yhetti/violet/README.md

# Violet
a GreatFET neighbor that is a jig for testing Gladiolus

Required KiCad dependency:

https://github.com/greatscottgadgets/gsg-kicad-lib

If you are using git, the preferred way to install gsg-kicad-lib is to use the
submodule:

```
git submodule init && git submodule update
```
