yhetti/violet/violet.kicad_pcb

## KiCad design violet.kicad_pcb (2021-01-21)

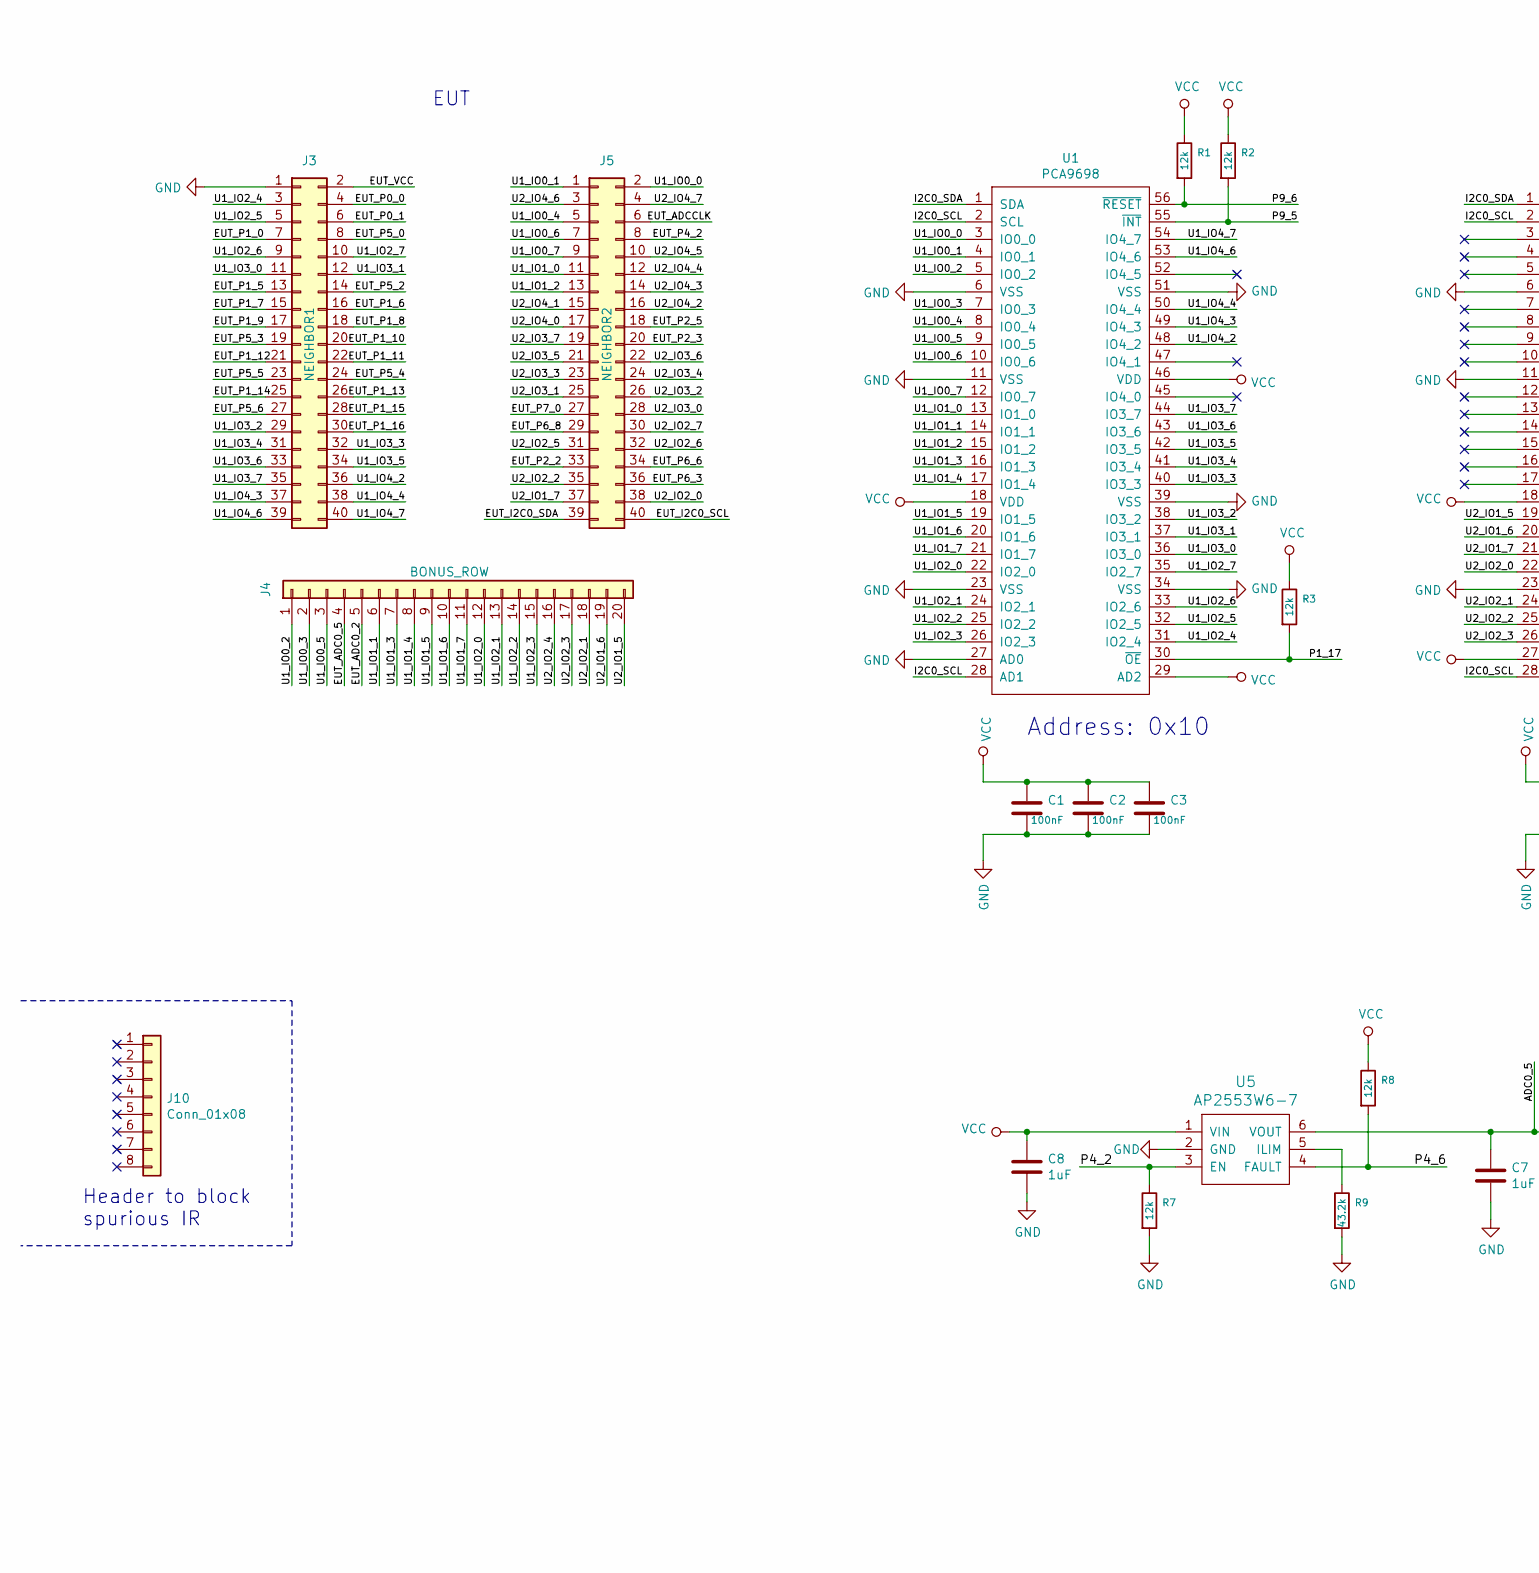
[picture p1: schematic violet.sch, part in row 1, column 1]

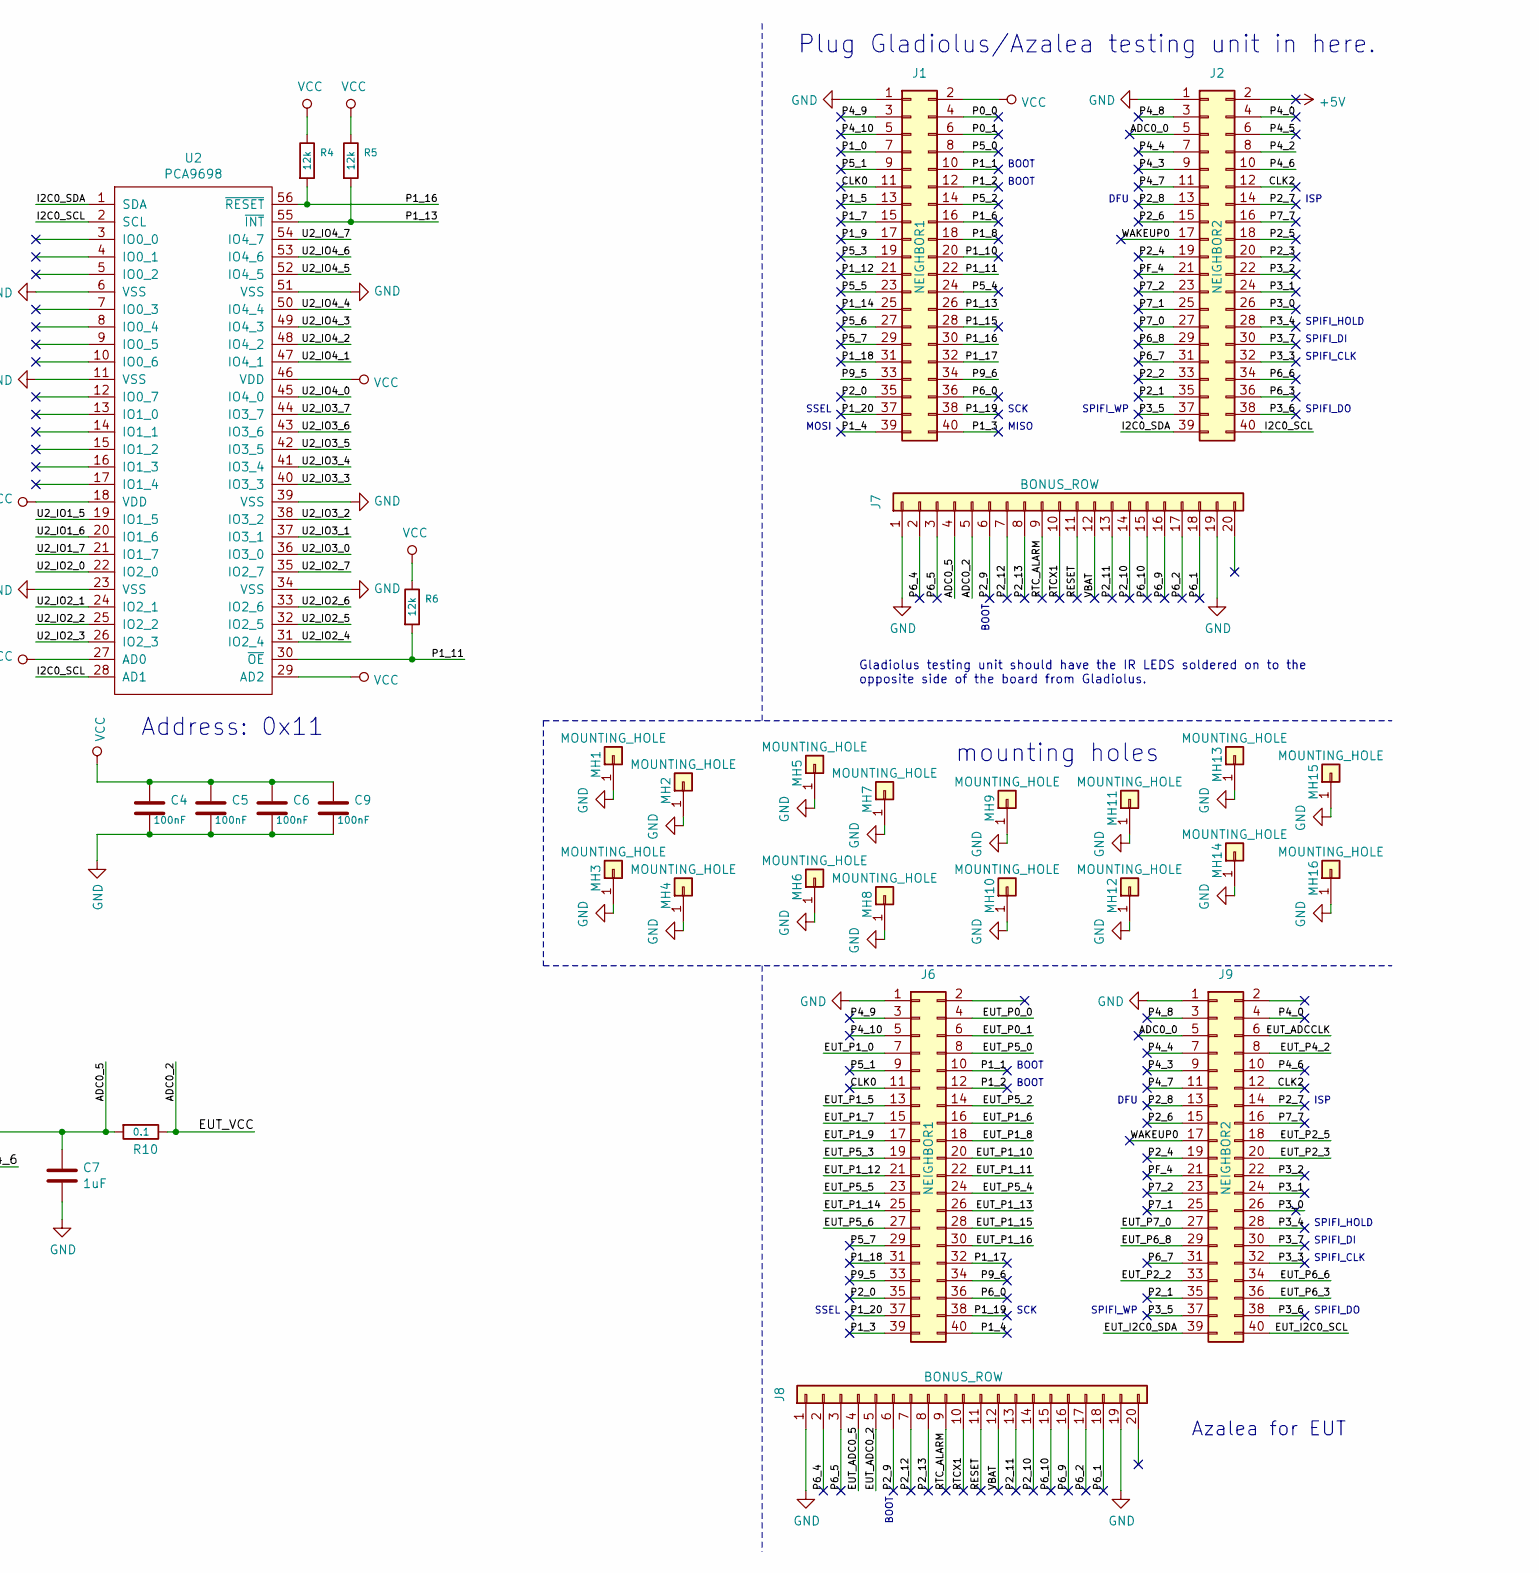
[picture p2: schematic violet.sch, part in row 1, column 2]

Parts:
C1, C2, C3, C4, C5, C6, C9: 100nF; 0603; Part Number C0603C104M4RACTU
C7, C8: 1uF; 0603; Part Number CL10A105KP8NNNC
J1, J3, J6: NEIGHBOR1; HEADER-2x20; Part Number PH2-20-UA
J2, J5, J9: NEIGHBOR2; HEADER-2x20; Part Number PH2-20-UA
J4, J7, J8: BONUS_ROW; HEADER-1x20; Part Number SSQ-120-23-G-S
J10: Conn_01x08; HEADER-1x8; Part Number SSQ-108-01-G-S
MH1, MH2, MH3, MH4, MH5, MH6, MH7, MH8, MH9, MH10, MH11, MH12, MH13, MH14, MH15, MH16: MOUNTING_HOLE; HOLE126MIL-COPPER
R1, R2, R3, R4, R5, R6, R7, R8: 12k; 0603; Part Number RMCF0603FT12K0
R9: 43.2k; 0603; Part Number RC0603FR-0743K2L
R10: 0.1; 0603; Part Number ERJ-3RSFR10V
U1, U2: PCA9698; TSSOP56; Part Number PCA9698DGG,512
U5: AP2553W6-7; SOT457

Connections:
+5V: J2.2
/ADC0_0: J2.5, J9.5
/ADC0_2: J3.2, J7.5, R10.1
/ADC0_5: C7.1, J7.4, R10.2, U5.6 (VOUT)
/CLK0: J1.11, J6.11
/CLK2: J2.12, J9.12
/EUT_ADC0_2: J4.5, J8.5
/EUT_ADC0_5: J4.4, J8.4
/EUT_ADCCLK: J5.6, J9.6
/EUT_I2C0_SCL: J5.40, J9.40
/EUT_I2C0_SDA: J5.39, J9.39
/EUT_P0_0: J3.4, J6.4
/EUT_P0_1: J3.6, J6.6
/EUT_P1_0: J3.7, J6.7
/EUT_P1_5: J3.13, J6.13
/EUT_P1_6: J3.16, J6.16
/EUT_P1_7: J3.15, J6.15
/EUT_P1_8: J3.18, J6.18
/EUT_P1_9: J3.17, J6.17
/EUT_P1_10: J3.20, J6.20
/EUT_P1_11: J3.22, J6.22
/EUT_P1_12: J3.21, J6.21
/EUT_P1_13: J3.26, J6.26
/EUT_P1_14: J3.25, J6.25
/EUT_P1_15: J3.28, J6.28
/EUT_P1_16: J3.30, J6.30
/EUT_P2_2: J5.33, J9.33
/EUT_P2_3: J5.20, J9.20
/EUT_P2_5: J5.18, J9.18
/EUT_P4_2: J5.8, J9.8
/EUT_P5_0: J3.8, J6.8
/EUT_P5_2: J3.14, J6.14
/EUT_P5_3: J3.19, J6.19
/EUT_P5_4: J3.24, J6.24
/EUT_P5_5: J3.23, J6.23
/EUT_P5_6: J3.27, J6.27
/EUT_P6_3: J5.36, J9.36
/EUT_P6_6: J5.34, J9.34
/EUT_P6_8: J5.29, J9.29
/EUT_P7_0: J5.27, J9.27
/I2C0_SCL: J2.40, U1.2 (SCL), U1.28 (AD1), U2.2 (SCL), U2.28 (AD1)
/I2C0_SDA: J2.39, U1.1 (SDA), U2.1 (SDA)
/P0_0: J1.4
/P0_1: J1.6
/P1_0: J1.7
/P1_1: J1.10, J6.10
/P1_2: J1.12, J6.12
/P1_3: J1.40, J6.39
/P1_4: J1.39, J6.40
/P1_5: J1.13
/P1_6: J1.16
/P1_7: J1.15
/P1_8: J1.18
/P1_9: J1.17
/P1_10: J1.20
/P1_11: J1.22, R6.2, U2.30 (~OE~)
/P1_12: J1.21
/P1_13: J1.26, R5.2, U2.55 (~INT~)
/P1_14: J1.25
/P1_15: J1.28
/P1_16: J1.30, R4.2, U2.56 (~RESET~)
/P1_17: J1.32, J6.32, R3.2, U1.30 (~OE~)
/P1_18: J1.31, J6.31
/P1_19: J1.38, J6.38
/P1_20: J1.37, J6.37
/P2_0: J1.35, J6.35
/P2_1: J2.35, J9.35
/P2_2: J2.33
/P2_3: J2.20
/P2_4: J2.19, J9.19
/P2_5: J2.18
/P2_6: J2.15, J9.15
/P2_7: J2.14, J9.14
/P2_8: J2.13, J9.13
/P2_9: J7.6, J8.6
/P2_10: J7.14, J8.14
/P2_11: J7.13, J8.13
/P2_12: J7.7, J8.7
/P2_13: J7.8, J8.8
/P3_0: J2.26, J9.26
/P3_1: J2.24, J9.24
/P3_2: J2.22, J9.22
/P3_3: J2.32, J9.32
/P3_4: J2.28, J9.28
/P3_5: J2.37, J9.37
/P3_6: J2.38, J9.38
/P3_7: J2.30, J9.30
/P4_0: J2.4, J9.4
/P4_2: J2.8, R7.1, U5.3 (EN)
/P4_3: J2.9, J9.9
/P4_4: J2.7, J9.7
/P4_5: J2.6
/P4_6: J2.10, J9.10, R8.2, U5.4 (FAULT)
/P4_7: J2.11, J9.11
/P4_8: J2.3, J9.3
/P4_9: J1.3, J6.3
/P4_10: J1.5, J6.5
/P5_0: J1.8
/P5_1: J1.9, J6.9
/P5_2: J1.14
/P5_3: J1.19
/P5_4: J1.24
/P5_5: J1.23
/P5_6: J1.27
/P5_7: J1.29, J6.29
/P6_0: J1.36, J6.36
/P6_1: J7.18, J8.18
/P6_2: J7.17, J8.17
/P6_3: J2.36
/P6_4: J7.2, J8.2
/P6_5: J7.3, J8.3
/P6_6: J2.34
/P6_7: J2.31, J9.31
/P6_8: J2.29
/P6_9: J7.16, J8.16
/P6_10: J7.15, J8.15
/P7_0: J2.27
/P7_1: J2.25, J9.25
/P7_2: J2.23, J9.23
/P7_7: J2.16, J9.16
/P9_5: J1.33, J6.33, R2.2, U1.55 (~INT~)
/P9_6: J1.34, J6.34, R1.2, U1.56 (~RESET~)
/PF_4: J2.21, J9.21
/RESET: J7.11, J8.11
/RTCX1: J7.10, J8.10
/RTC_ALARM: J7.9, J8.9
/U1_IO0_0: J5.2, U1.3 (IO0_0)
/U1_IO0_1: J5.1, U1.4 (IO0_1)
/U1_IO0_2: J4.1, U1.5 (IO0_2)
/U1_IO0_3: J4.2, U1.7 (IO0_3)
/U1_IO0_4: J5.5, U1.8 (IO0_4)
/U1_IO0_5: J4.3, U1.9 (IO0_5)
/U1_IO0_6: J5.7, U1.10 (IO0_6)
/U1_IO0_7: J5.9, U1.12 (IO0_7)
/U1_IO1_0: J5.11, U1.13 (IO1_0)
/U1_IO1_1: J4.6, U1.14 (IO1_1)
/U1_IO1_2: J5.13, U1.15 (IO1_2)
/U1_IO1_3: J4.7, U1.16 (IO1_3)
/U1_IO1_4: J4.8, U1.17 (IO1_4)
/U1_IO1_5: J4.9, U1.19 (IO1_5)
/U1_IO1_6: J4.10, U1.20 (IO1_6)
/U1_IO1_7: J4.11, U1.21 (IO1_7)
/U1_IO2_0: J4.12, U1.22 (IO2_0)
/U1_IO2_1: J4.13, U1.24 (IO2_1)
/U1_IO2_2: J4.14, U1.25 (IO2_2)
/U1_IO2_3: J4.15, U1.26 (IO2_3)
/U1_IO2_4: J3.3, U1.31 (IO2_4)
/U1_IO2_5: J3.5, U1.32 (IO2_5)
/U1_IO2_6: J3.9, U1.33 (IO2_6)
/U1_IO2_7: J3.10, U1.35 (IO2_7)
/U1_IO3_0: J3.11, U1.36 (IO3_0)
/U1_IO3_1: J3.12, U1.37 (IO3_1)
/U1_IO3_2: J3.29, U1.38 (IO3_2)
/U1_IO3_3: J3.32, U1.40 (IO3_3)
/U1_IO3_4: J3.31, U1.41 (IO3_4)
/U1_IO3_5: J3.34, U1.42 (IO3_5)
/U1_IO3_6: J3.33, U1.43 (IO3_6)
/U1_IO3_7: J3.35, U1.44 (IO3_7)
/U1_IO4_2: J3.36, U1.48 (IO4_2)
/U1_IO4_3: J3.37, U1.49 (IO4_3)
/U1_IO4_4: J3.38, U1.50 (IO4_4)
/U1_IO4_6: J3.39, U1.53 (IO4_6)
/U1_IO4_7: J3.40, U1.54 (IO4_7)
/U2_IO1_5: J4.20, U2.19 (IO1_5)
/U2_IO1_6: J4.19, U2.20 (IO1_6)
/U2_IO1_7: J5.37, U2.21 (IO1_7)
/U2_IO2_0: J5.38, U2.22 (IO2_0)
/U2_IO2_1: J4.18, U2.24 (IO2_1)
/U2_IO2_2: J5.35, U2.25 (IO2_2)
/U2_IO2_3: J4.17, U2.26 (IO2_3)
/U2_IO2_4: J4.16, U2.31 (IO2_4)
/U2_IO2_5: J5.31, U2.32 (IO2_5)
/U2_IO2_6: J5.32, U2.33 (IO2_6)
/U2_IO2_7: J5.30, U2.35 (IO2_7)
/U2_IO3_0: J5.28, U2.36 (IO3_0)
/U2_IO3_1: J5.25, U2.37 (IO3_1)
/U2_IO3_2: J5.26, U2.38 (IO3_2)
/U2_IO3_3: J5.23, U2.40 (IO3_3)
/U2_IO3_4: J5.24, U2.41 (IO3_4)
/U2_IO3_5: J5.21, U2.42 (IO3_5)
/U2_IO3_6: J5.22, U2.43 (IO3_6)
/U2_IO3_7: J5.19, U2.44 (IO3_7)
/U2_IO4_0: J5.17, U2.45 (IO4_0)
/U2_IO4_1: J5.15, U2.47 (IO4_1)
/U2_IO4_2: J5.16, U2.48 (IO4_2)
/U2_IO4_3: J5.14, U2.49 (IO4_3)
/U2_IO4_4: J5.12, U2.50 (IO4_4)
/U2_IO4_5: J5.10, U2.52 (IO4_5)
/U2_IO4_6: J5.3, U2.53 (IO4_6)
/U2_IO4_7: J5.4, U2.54 (IO4_7)
/VBAT: J7.12, J8.12
/WAKEUP0: J2.17, J9.17
GND: C1.2, C2.2, C3.2, C4.2, C5.2, C6.2, C7.2, C8.2, C9.2, J1.1, J2.1, J3.1, J6.1, J7.1, J7.19, J8.1, J8.19, J9.1, MH1.1, MH2.1, MH3.1, MH4.1, MH5.1, MH6.1, MH7.1, MH8.1, MH9.1, MH10.1, MH11.1, MH12.1, MH13.1, MH14.1, MH15.1, MH16.1, R7.2, R9.2, U1.6 (VSS), U1.11 (VSS), U1.23 (VSS), U1.27 (AD0), U1.34 (VSS), U1.39 (VSS), U1.51 (VSS), U2.6 (VSS), U2.11 (VSS), U2.23 (VSS), U2.34 (VSS), U2.39 (VSS), U2.51 (VSS), U5.2 (GND)
unnamed: R9.1, U5.5 (ILIM)
VCC: C1.1, C2.1, C3.1, C4.1, C5.1, C6.1, C8.1, C9.1, J1.2, R1.1, R2.1, R3.1, R4.1, R5.1, R6.1, R8.1, U1.18 (VDD), U1.29 (AD2), U1.46 (VDD), U2.18 (VDD), U2.27 (AD0), U2.29 (AD2), U2.46 (VDD), U5.1 (VIN)

Notes on the sheet:
MISO
MOSI
SCK
SSEL
ISP
DFU
BOOT
SPIFI_CLK
SPIFI_HOLD
SPIFI_WP
SPIFI_DO
SPIFI_DI
Gladiolus testing unit should have the IR LEDS soldered on to the opposite side of the board from Gladiolus.
Plug Gladiolus/Azalea testing unit in here.
mounting holes
EUT
Azalea for EUT
Address: 0x10
Address: 0x11
Header to block spurious IR

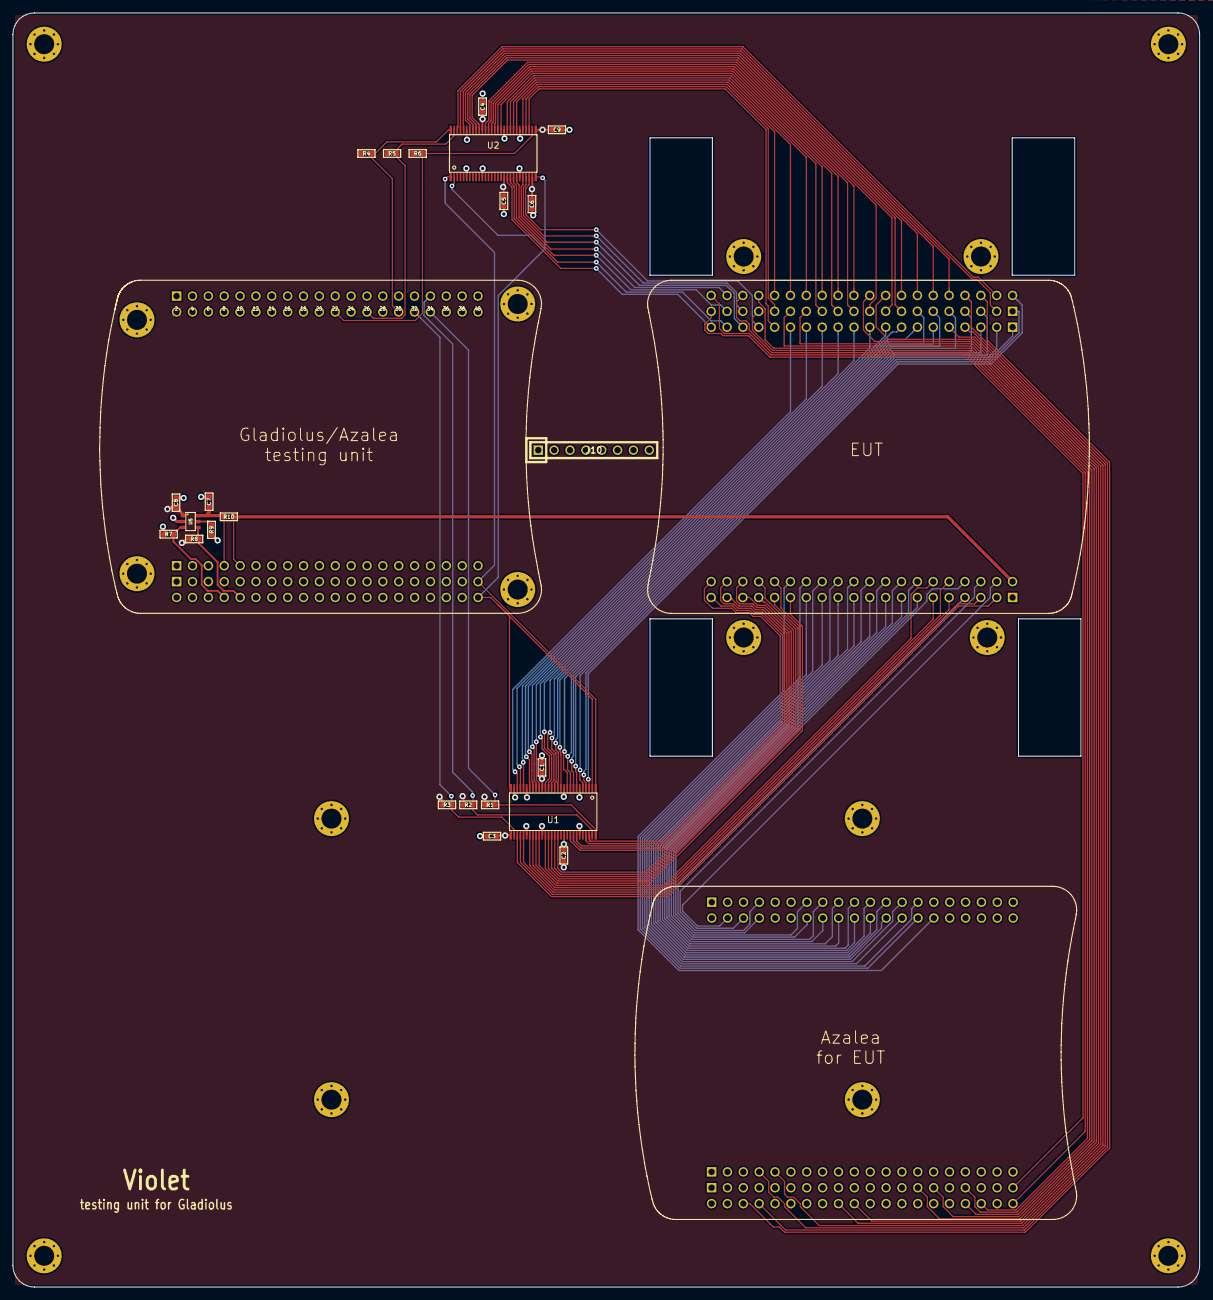
[picture p3: board violet.kicad_pcb from above]

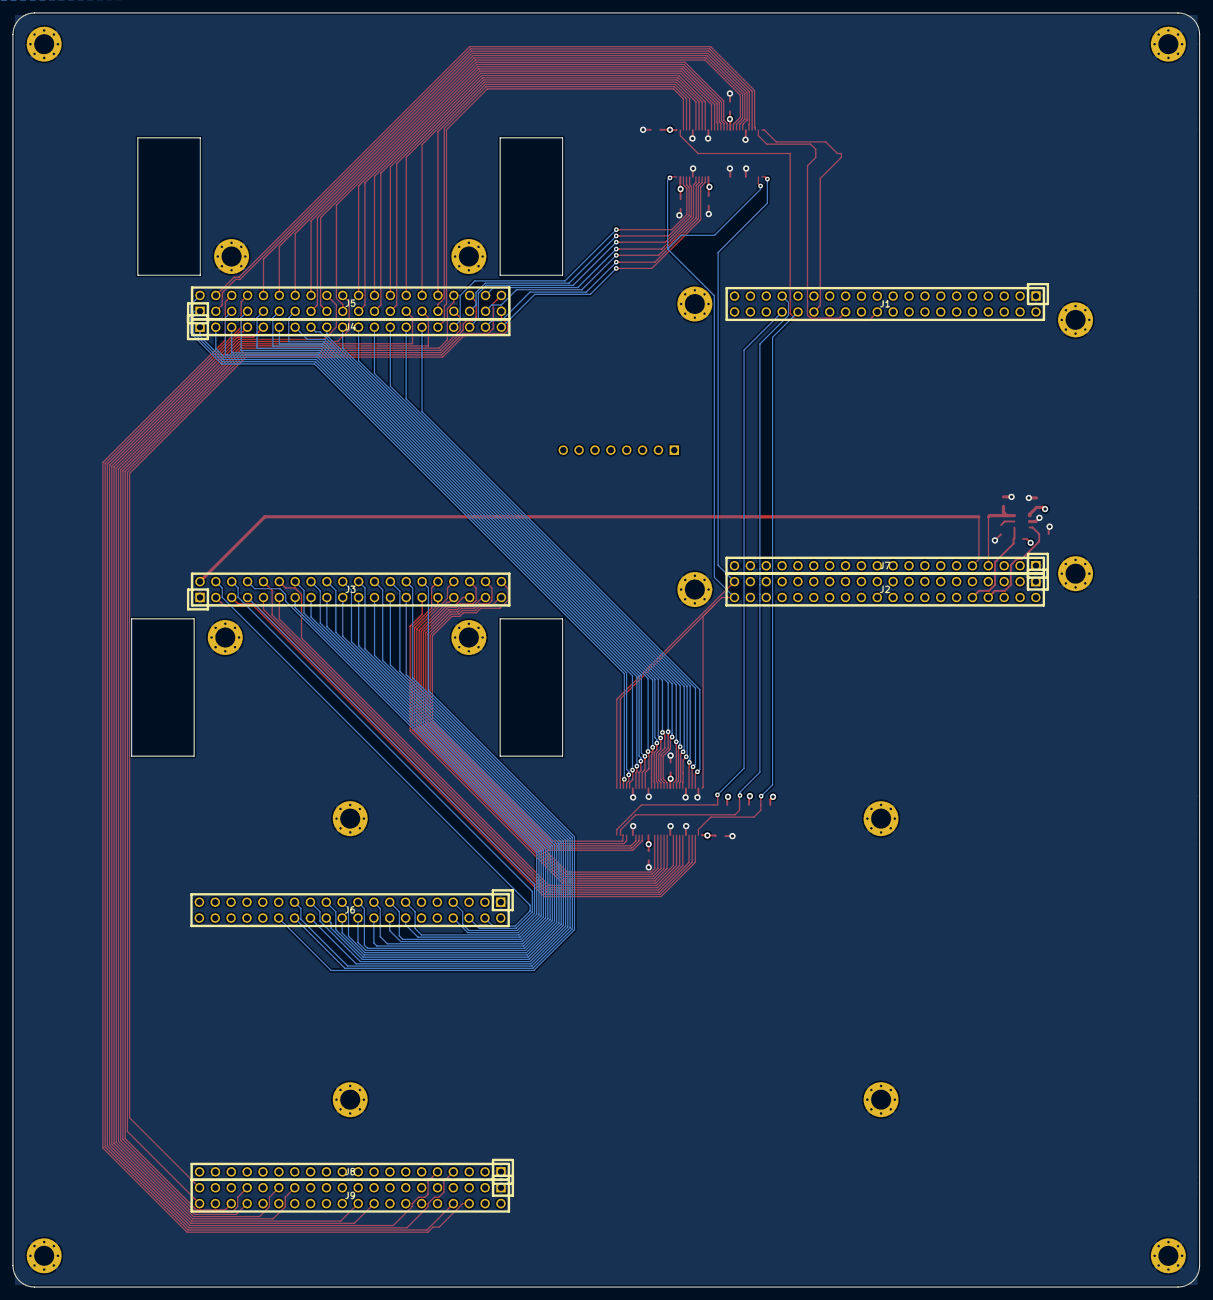
[picture p4: board violet.kicad_pcb from below]

Board: 2 copper layers, 190.0 x 204.0 mm, 48 parts (9 on the bottom side), 168 nets.
