yhetti/violet/(commit log)

2020-02-29 Initial commit; Create kicad files; Add gsg-kicad-lib submodule
    [violet.kicad_pcb, violet.sch]
2020-09-24 set up initial configuration of headers
    [violet.kicad_pcb, violet.sch]
2020-09-24 Add header set for EUT Azalea; wire RX/TX signals between EUT and EUT Azalea
    [violet.sch]
2021-01-07 Add labels to I/O expanders and headers
    [violet.sch]
2021-01-08 Add more labels; fix label nomenclature
    [violet.sch]
2021-01-09 Add more labels; add another I/O expander
    [violet.sch]
2021-01-12 Add remaining labels; configure third I/O expander; add decoupling caps
    [violet.sch]
2021-01-12 Add parts and footprints
    [violet.sch]
2021-01-12 Annotate schematic symbols
    [violet.sch]
2021-01-14 Remove U3 & U4; re-label signals; set up U5; fix U1 &U2 I2C addresses; fix minor errors
    [violet.sch]
2021-01-15 Add remaining footprints
    [violet.sch]
2021-01-15 Place and orient headers on pcb
    [violet.kicad_pcb]
2021-01-16 Layout power supply for EUT
    [violet.kicad_pcb]
2021-01-19 Wire J6 to J3
    [violet.kicad_pcb]
2021-01-19 Add more mounting holes
    [violet.sch]
2021-01-19 Fix mounting hole footprints
    [violet.sch]
2021-01-20 Wire J8/9 to J4/5; place new mounting holes; begin wiring U1
    [violet.kicad_pcb]
2021-01-20 Re-map I/O expanders for easier routing
    [violet.kicad_pcb, violet.sch]
2021-01-21 Route most of U1
    [violet.kicad_pcb, violet.sch]
2021-01-21 Complete routing of PCB; update routing in schematic for ease of routing on PCB
    [violet.kicad_pcb, violet.sch]
